MRThermostat/TCU/README.md

# TCU
hardware/software for thermostat control unit
