MRThermostat/TCU/order_confirmation.PNG

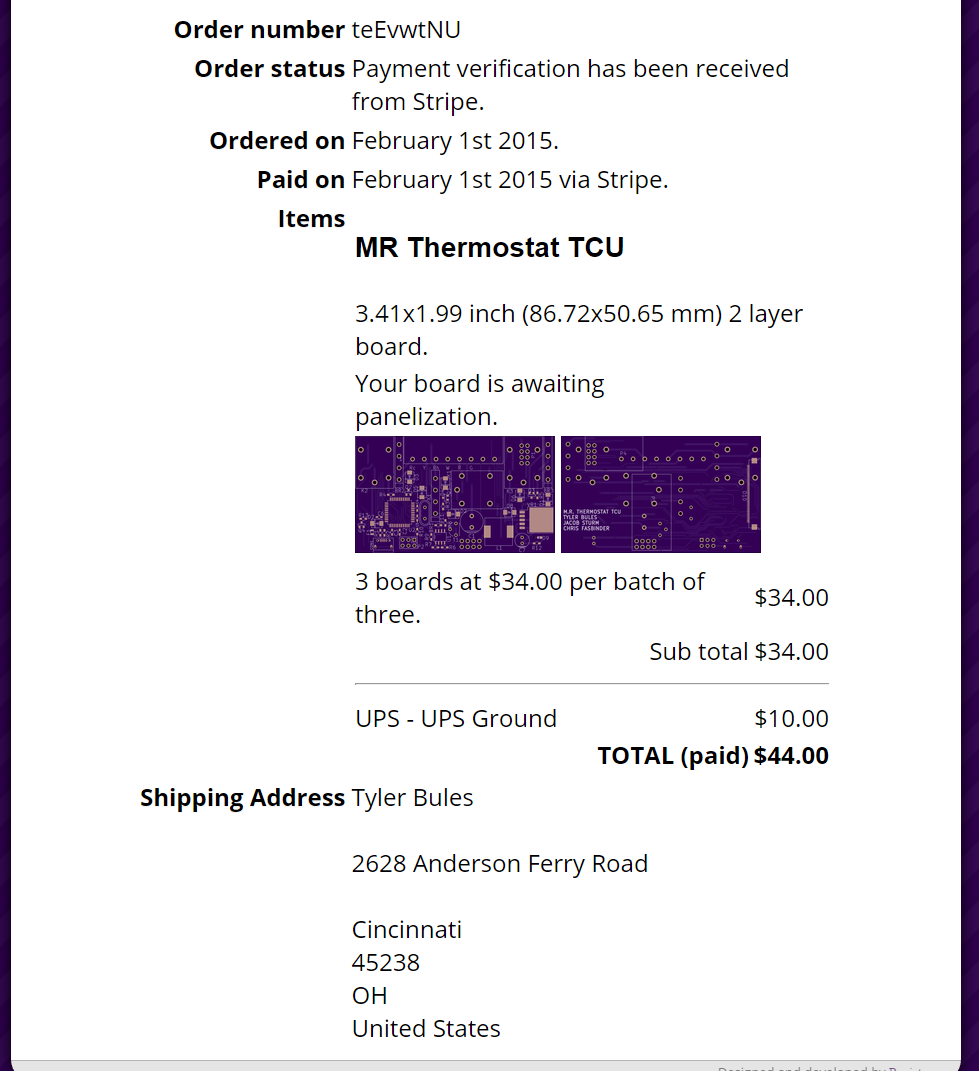
order_confirmation.PNG
