MRThermostat/TCU/TCU_HARDWARE/tcu.pdf

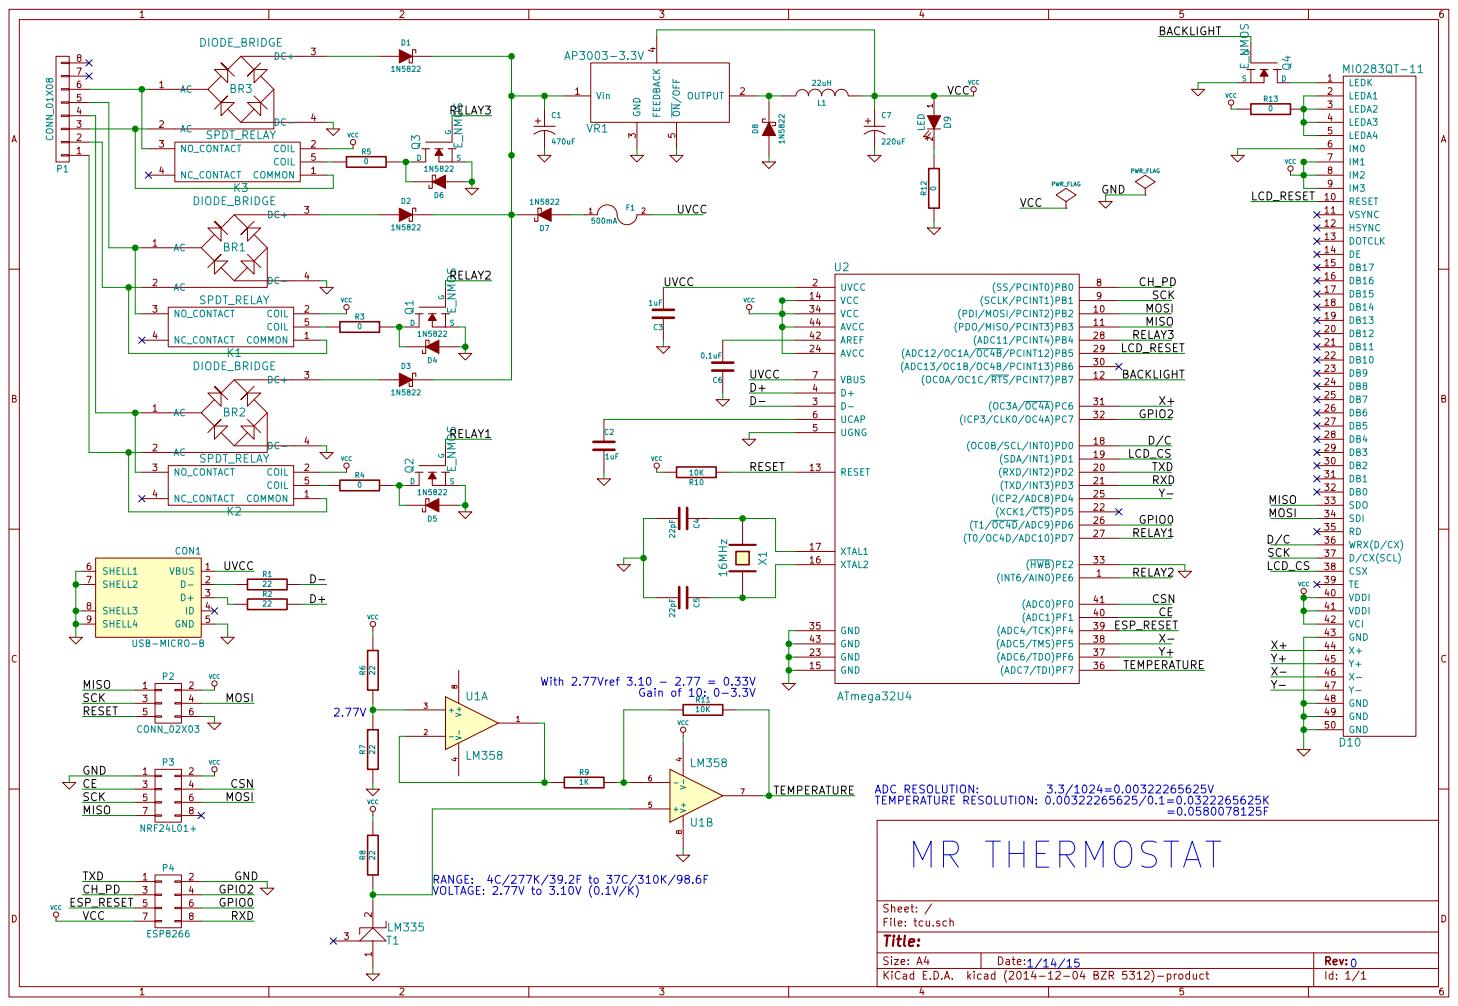
[picture p2: page 1]

MR THERMOSTAT
