MRThermostat/TCU/TCU_HARDWARE/tcu-B_Cu.pdf

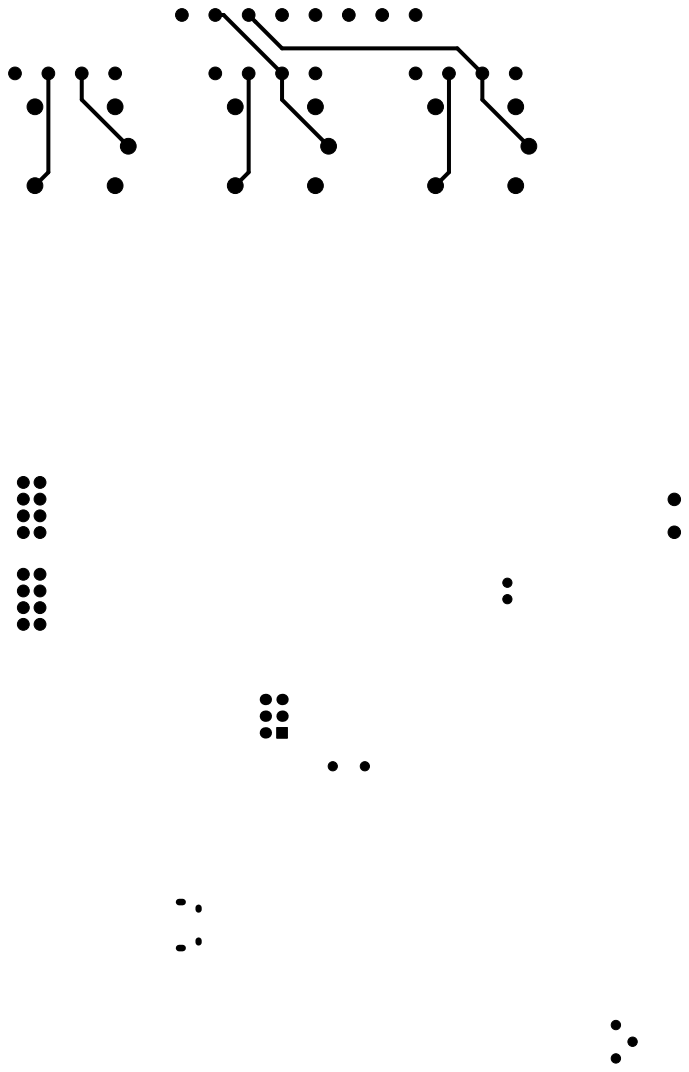
[picture p3: page 1]
