MRThermostat/TCU/TCU_HARDWARE/tcu-B_SilkS.pdf

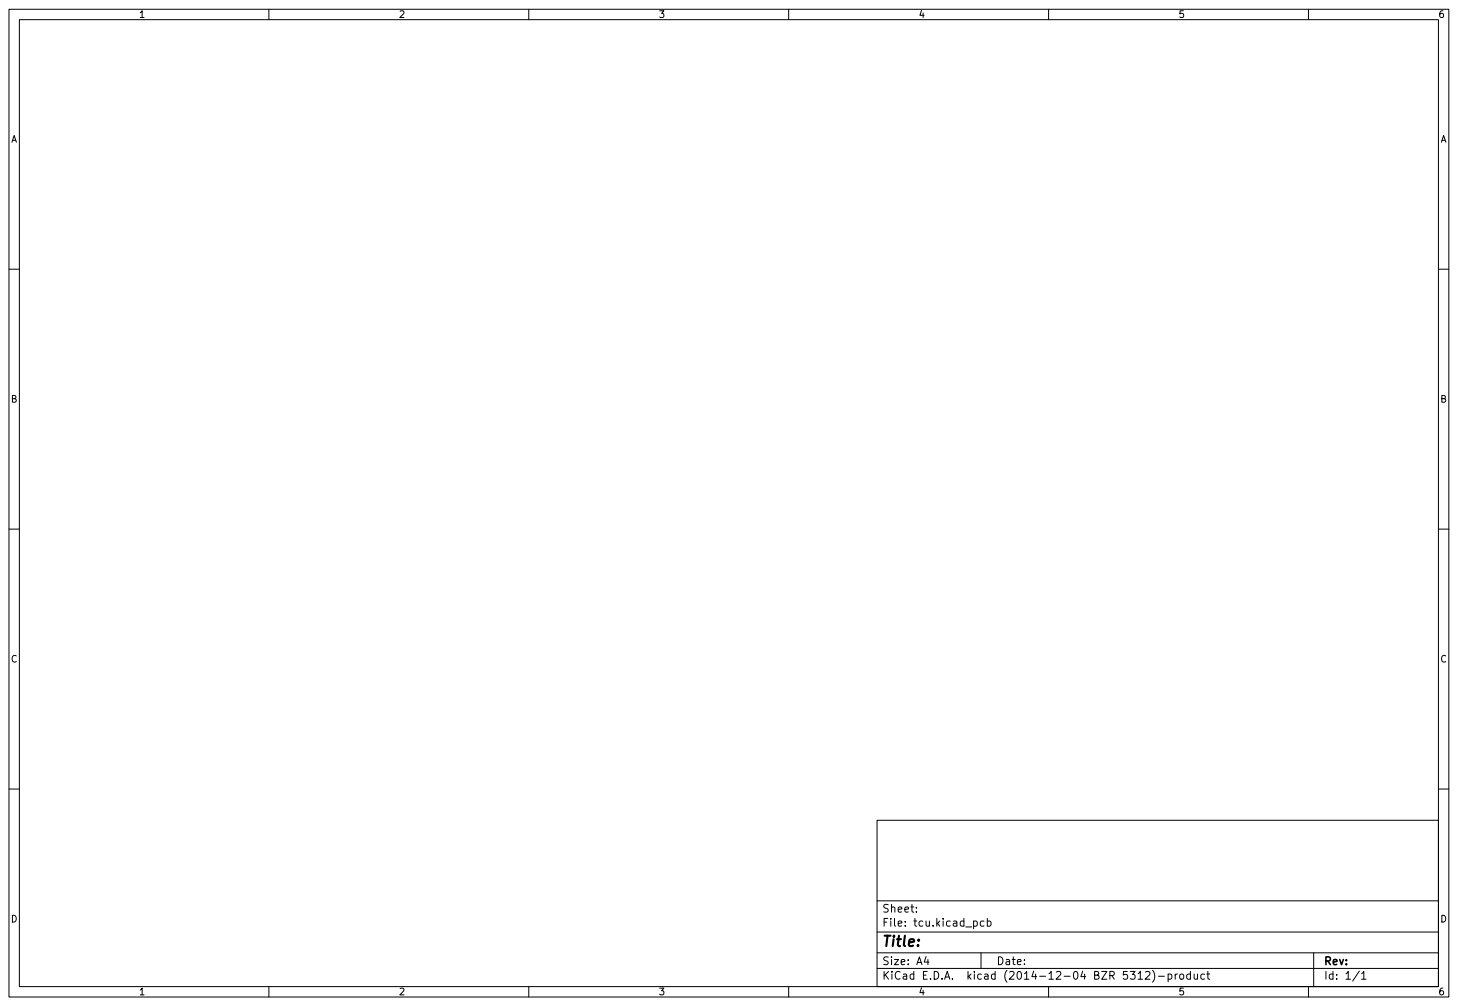
[picture p4: page 1]
