MRThermostat/TCU/TCU_HARDWARE/tcu-F_Cu.pdf

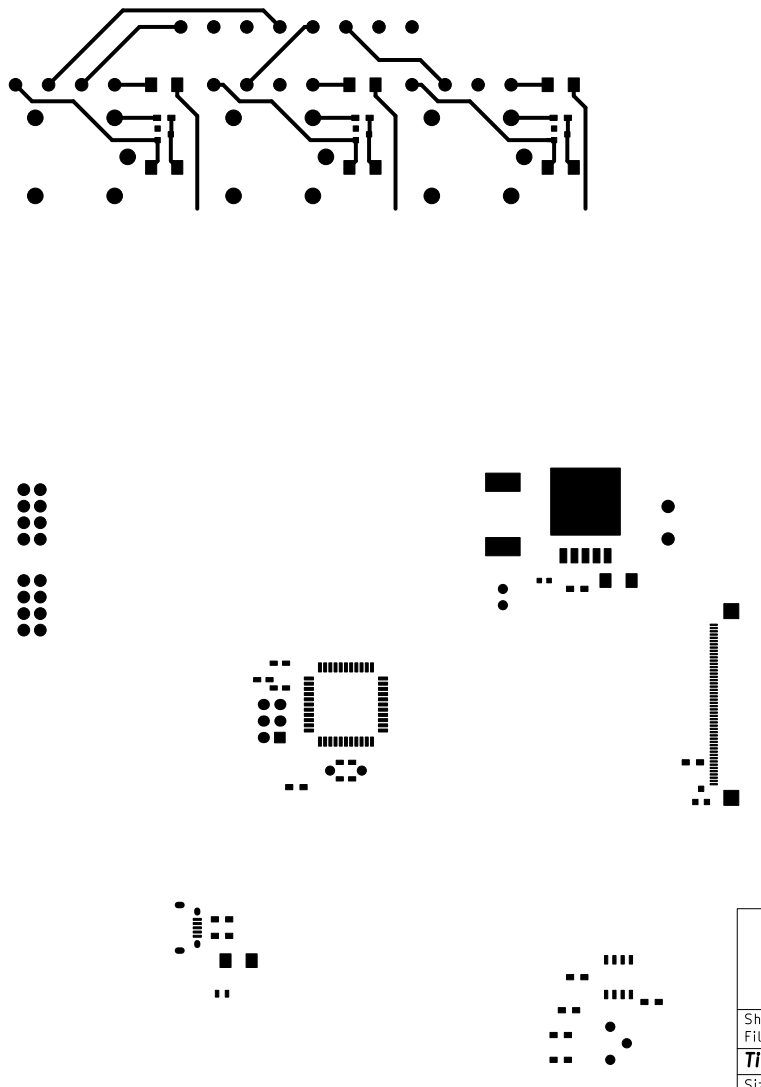
[picture p5: page 1]
