MRThermostat/TCU/TCU_HARDWARE/tcu-F_SilkS.pdf

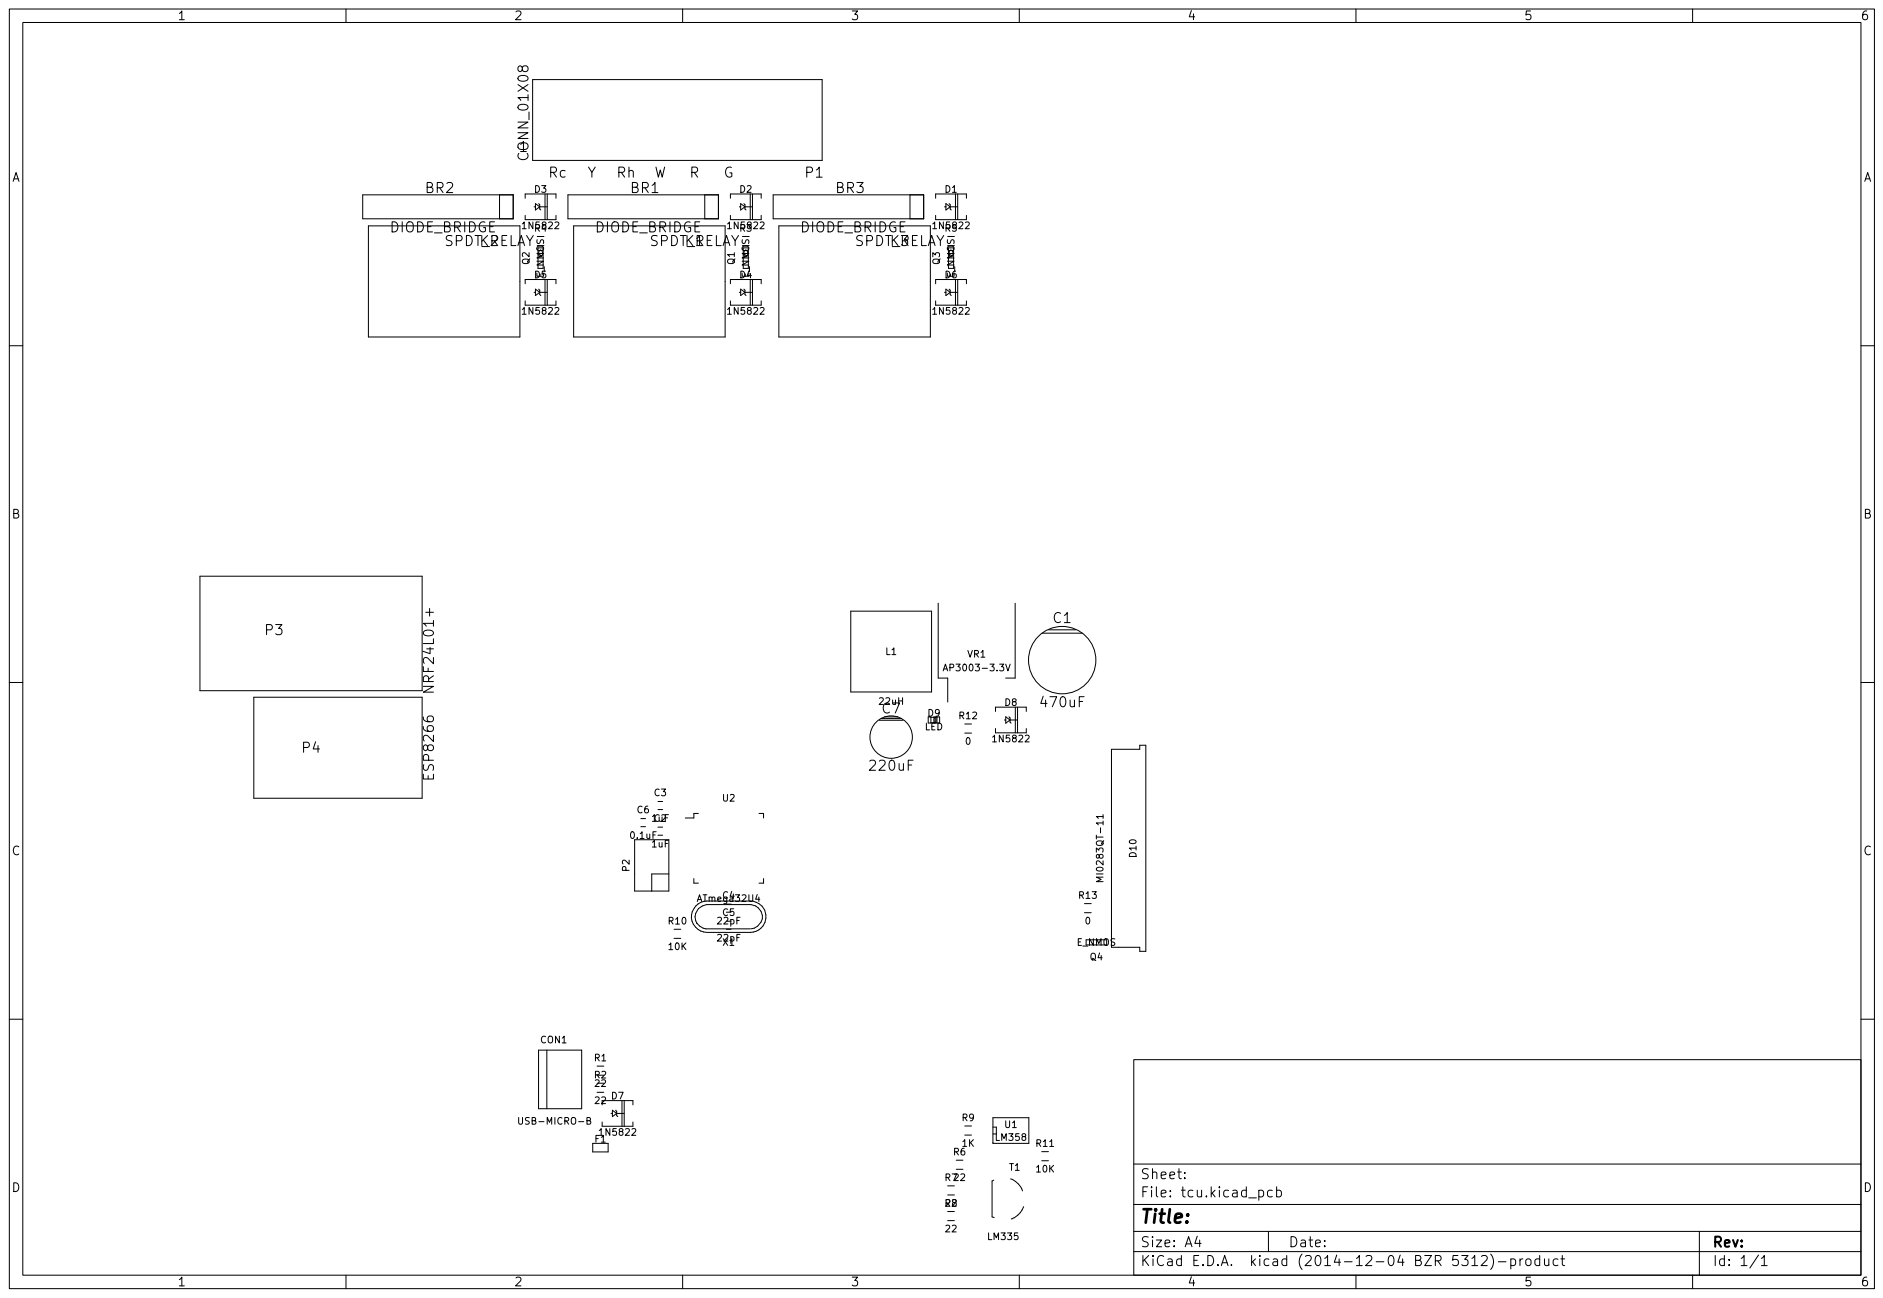
[picture p6: page 1]
