MRThermostat/TCU/TCU_HARDWARE/gerbers/tcu-B_Cu.pdf

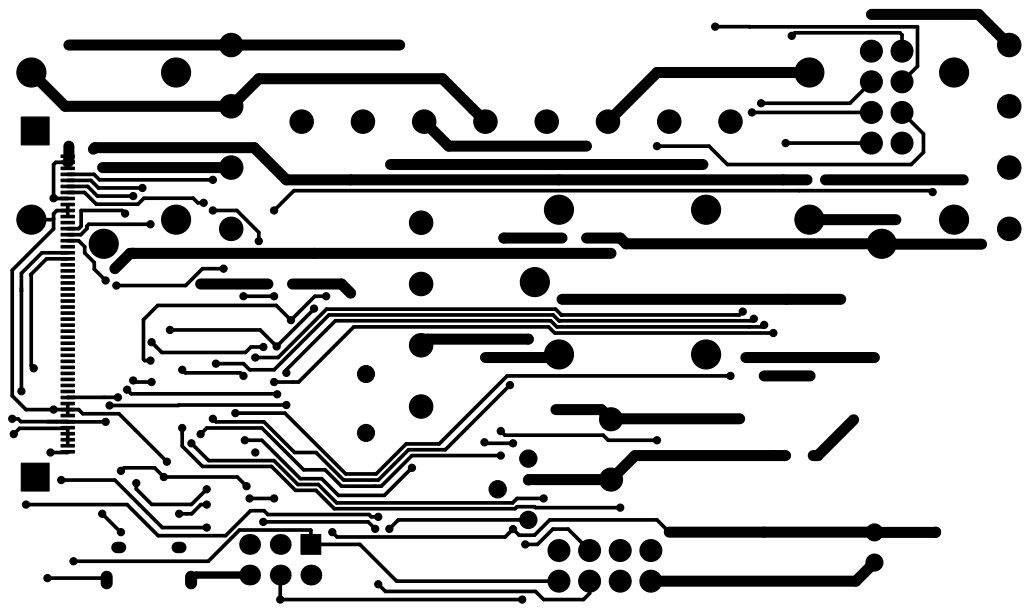
[picture p7: page 1]
