MRThermostat/TCU/TCU_HARDWARE/gerbers/tcu-B_Mask.pdf

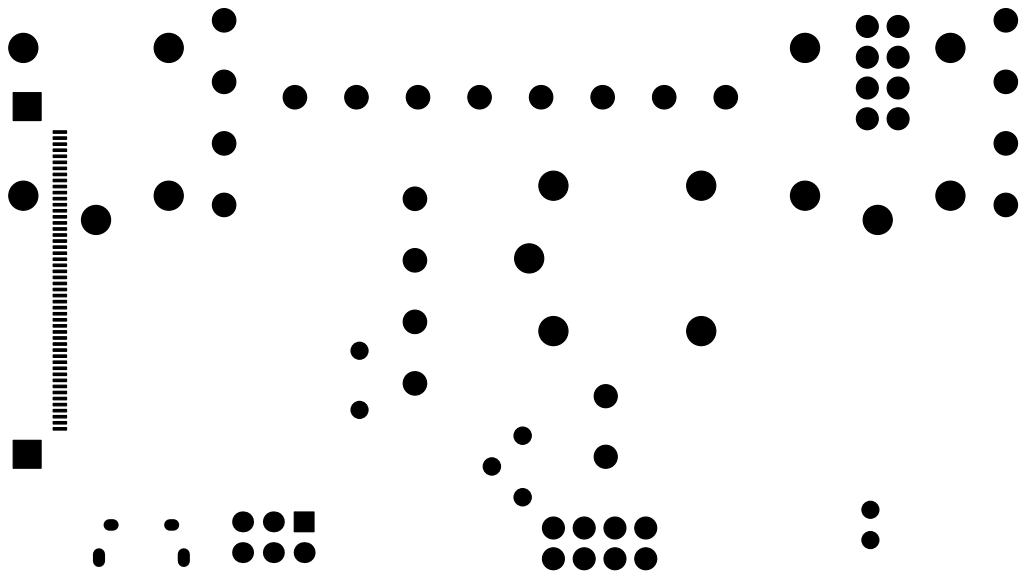
[picture p8: page 1]
