MRThermostat/TCU/TCU_HARDWARE/gerbers/tcu-B_SilkS.pdf

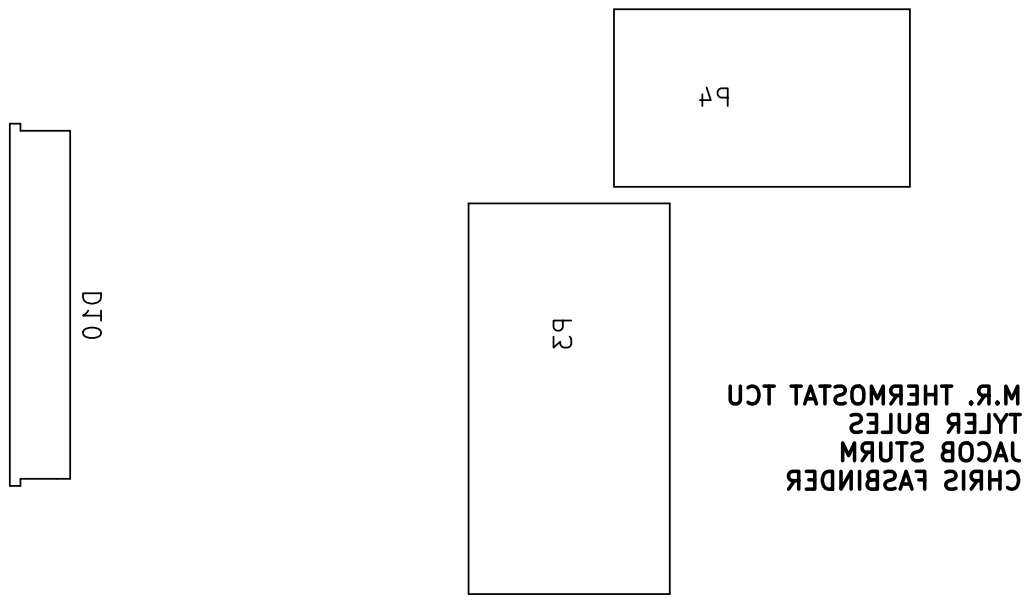
[picture p9: page 1]
