MRThermostat/TCU/TCU_HARDWARE/gerbers/tcu-F_Cu.pdf

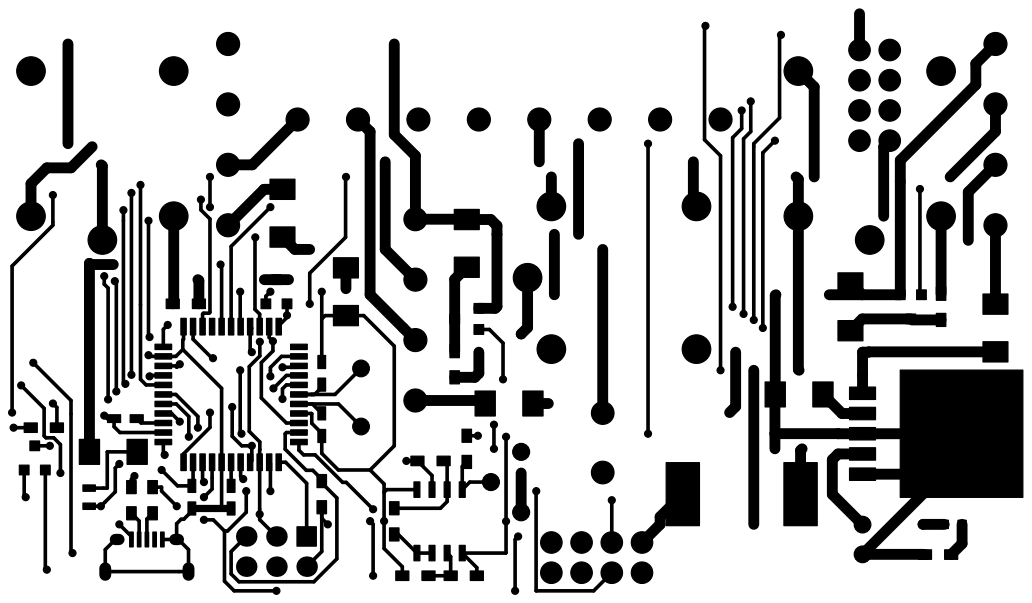
[picture p10: page 1]
