MRThermostat/TCU/TCU_HARDWARE/gerbers/tcu-F_Mask.pdf

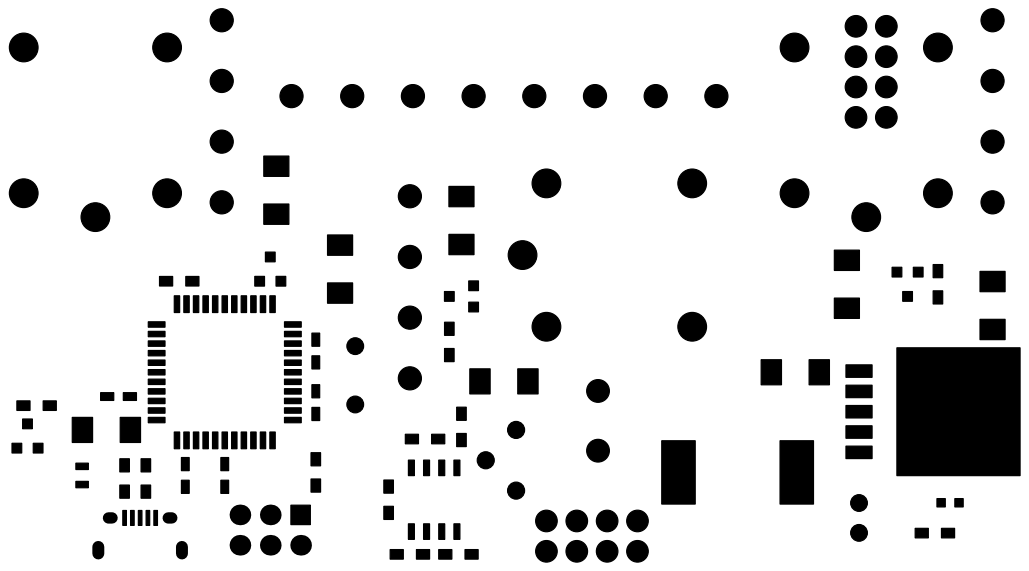
[picture p11: page 1]
