MRThermostat/TCU/TCU_HARDWARE/gerbers/tcu-F_SilkS.pdf

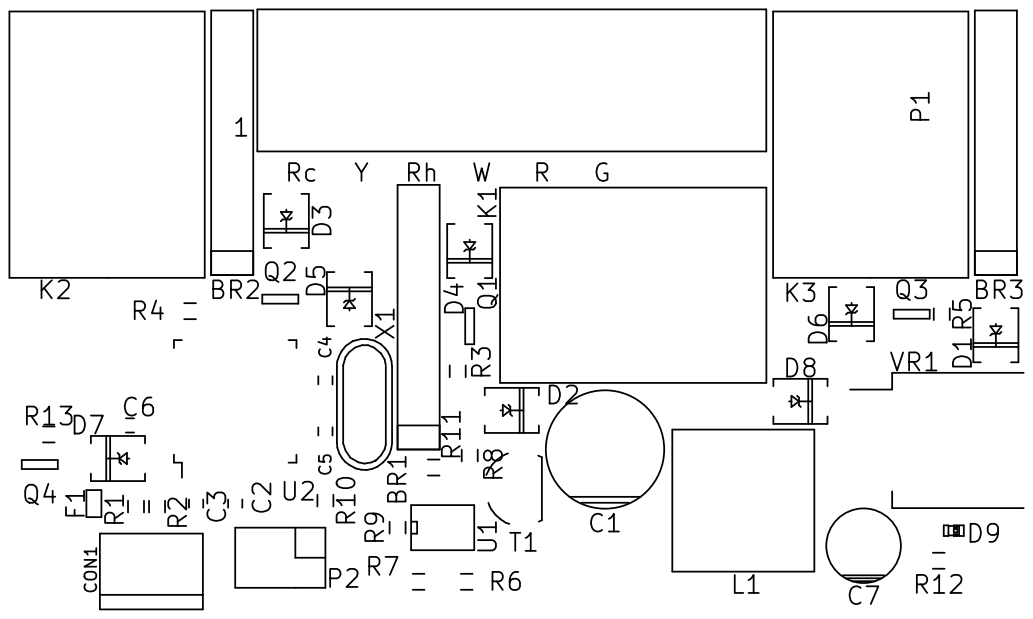
[picture p12: page 1]
