MRThermostat/TCU/ENG_CD_796638_C6.pdf

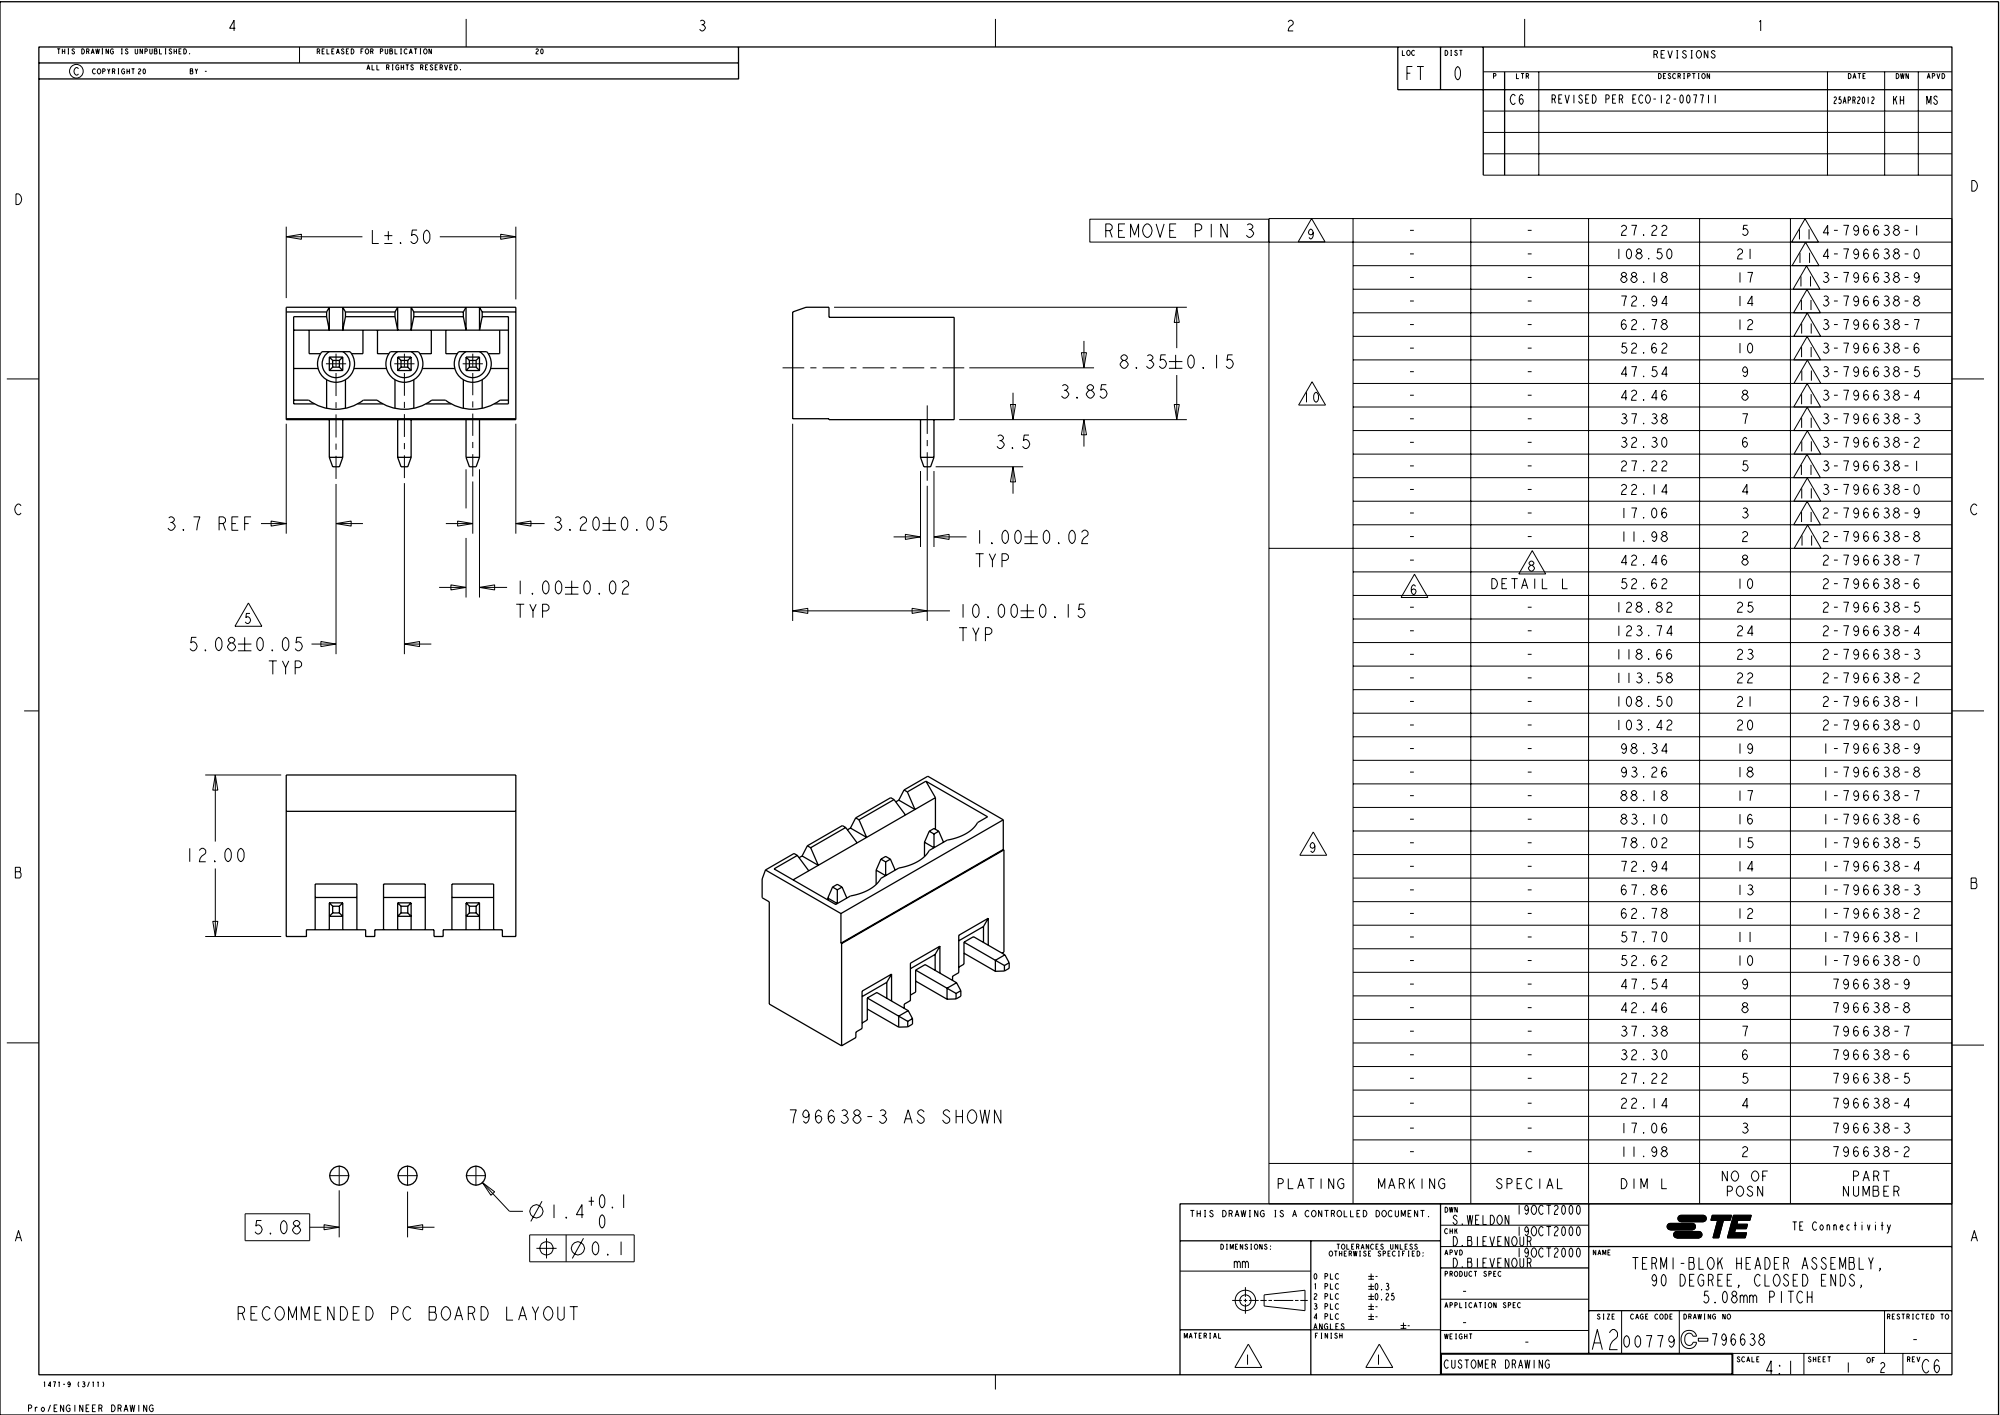
[picture p13: page 1]

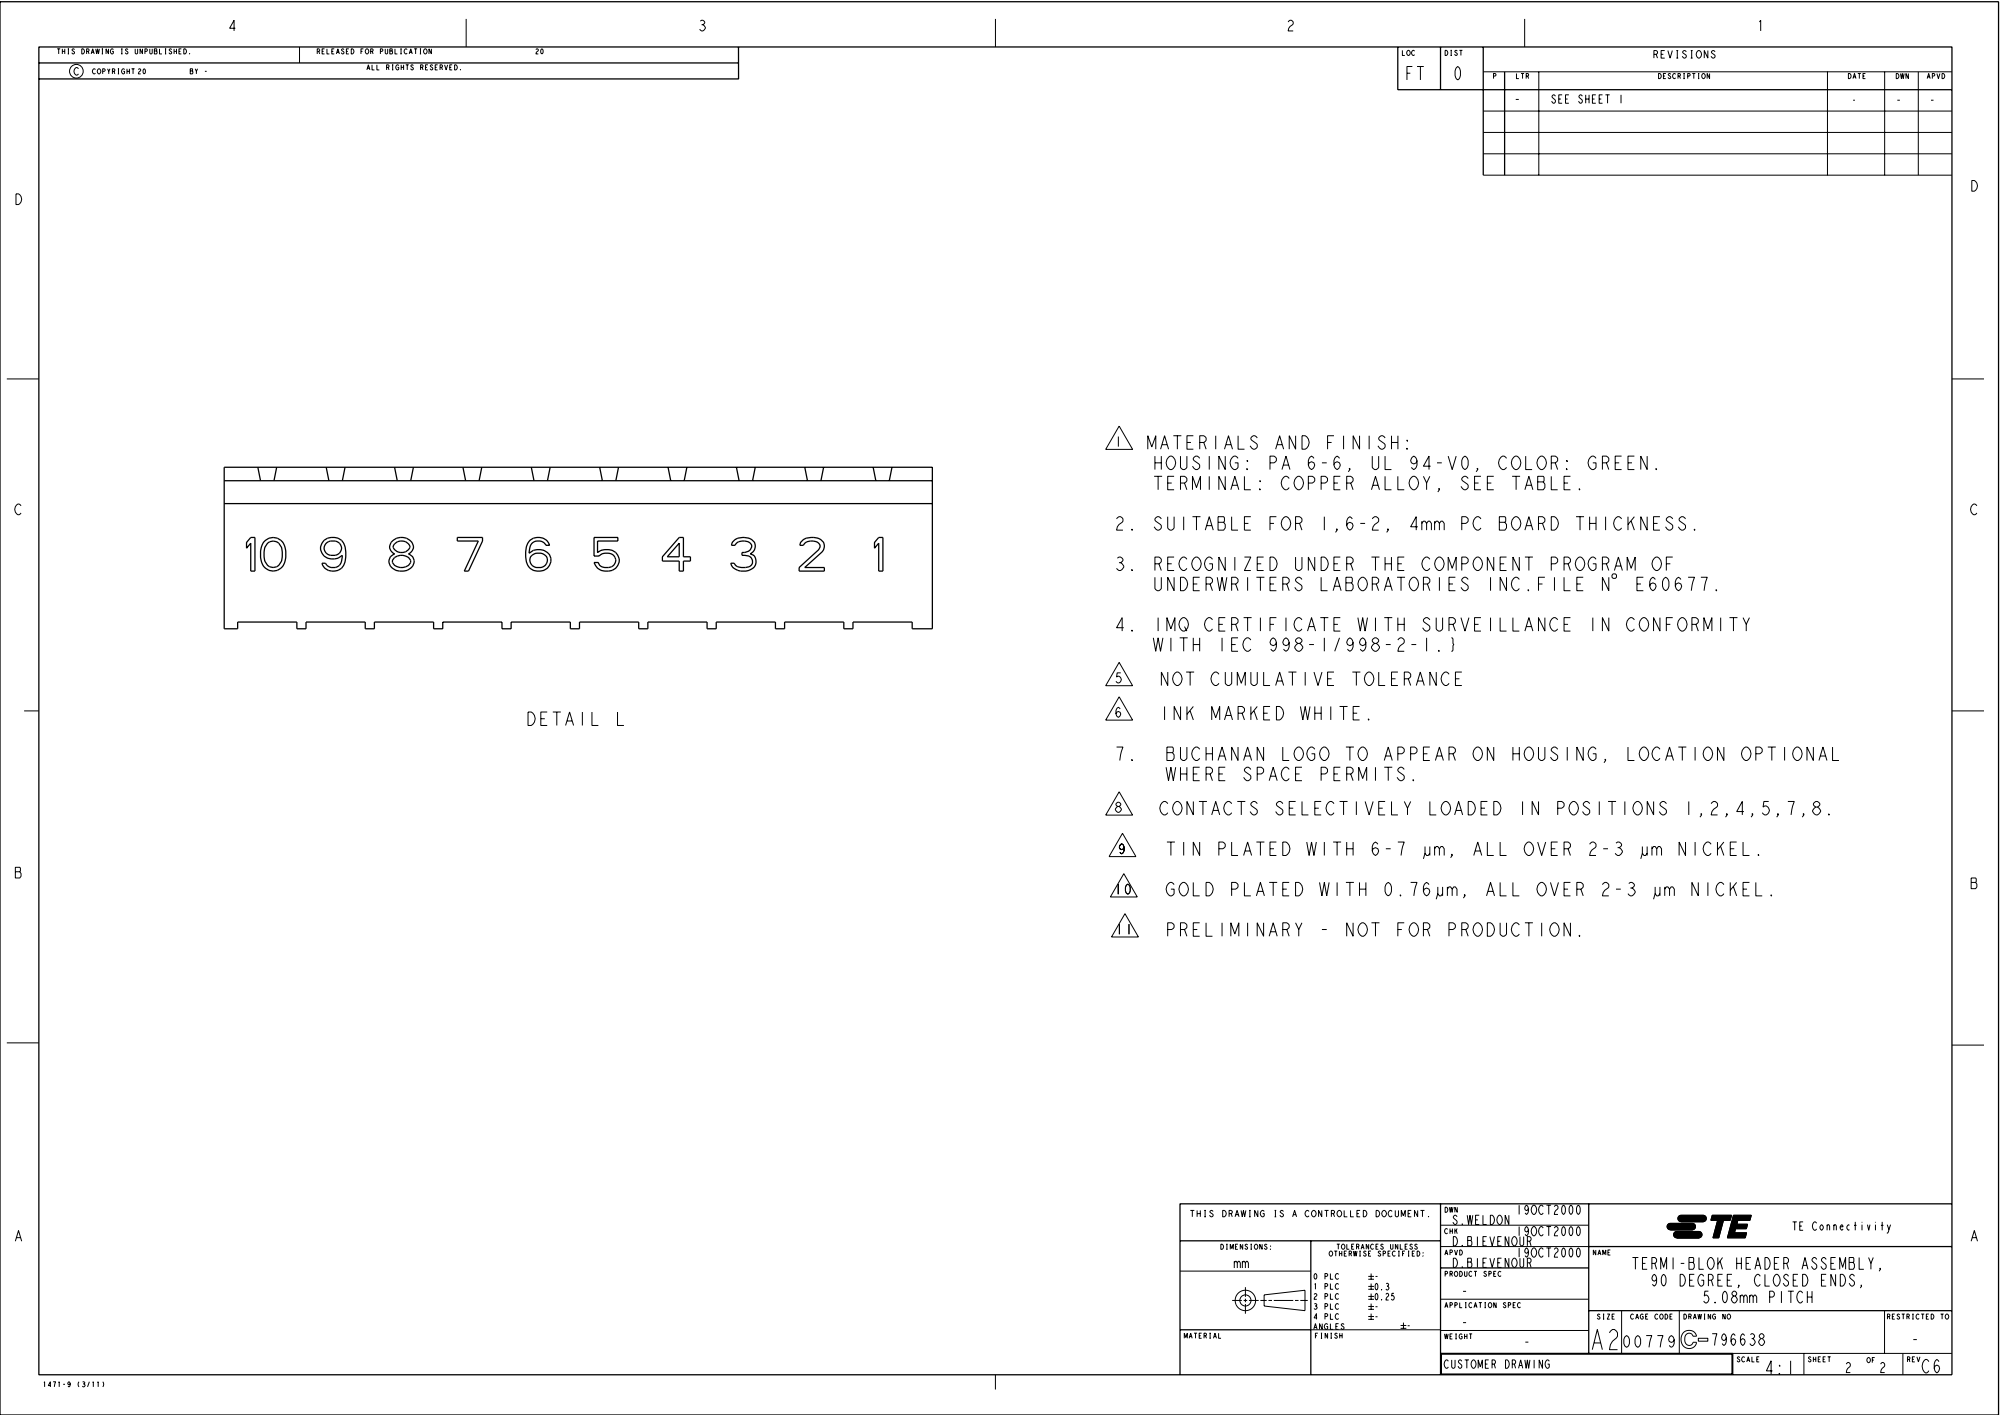
[picture p14: page 2]
