MRThermostat/TCU/TCU_HARDWARE/tcu.kicad_pcb

## KiCad design TCU_HARDWARE/tcu.kicad_pcb (2015-02-01)

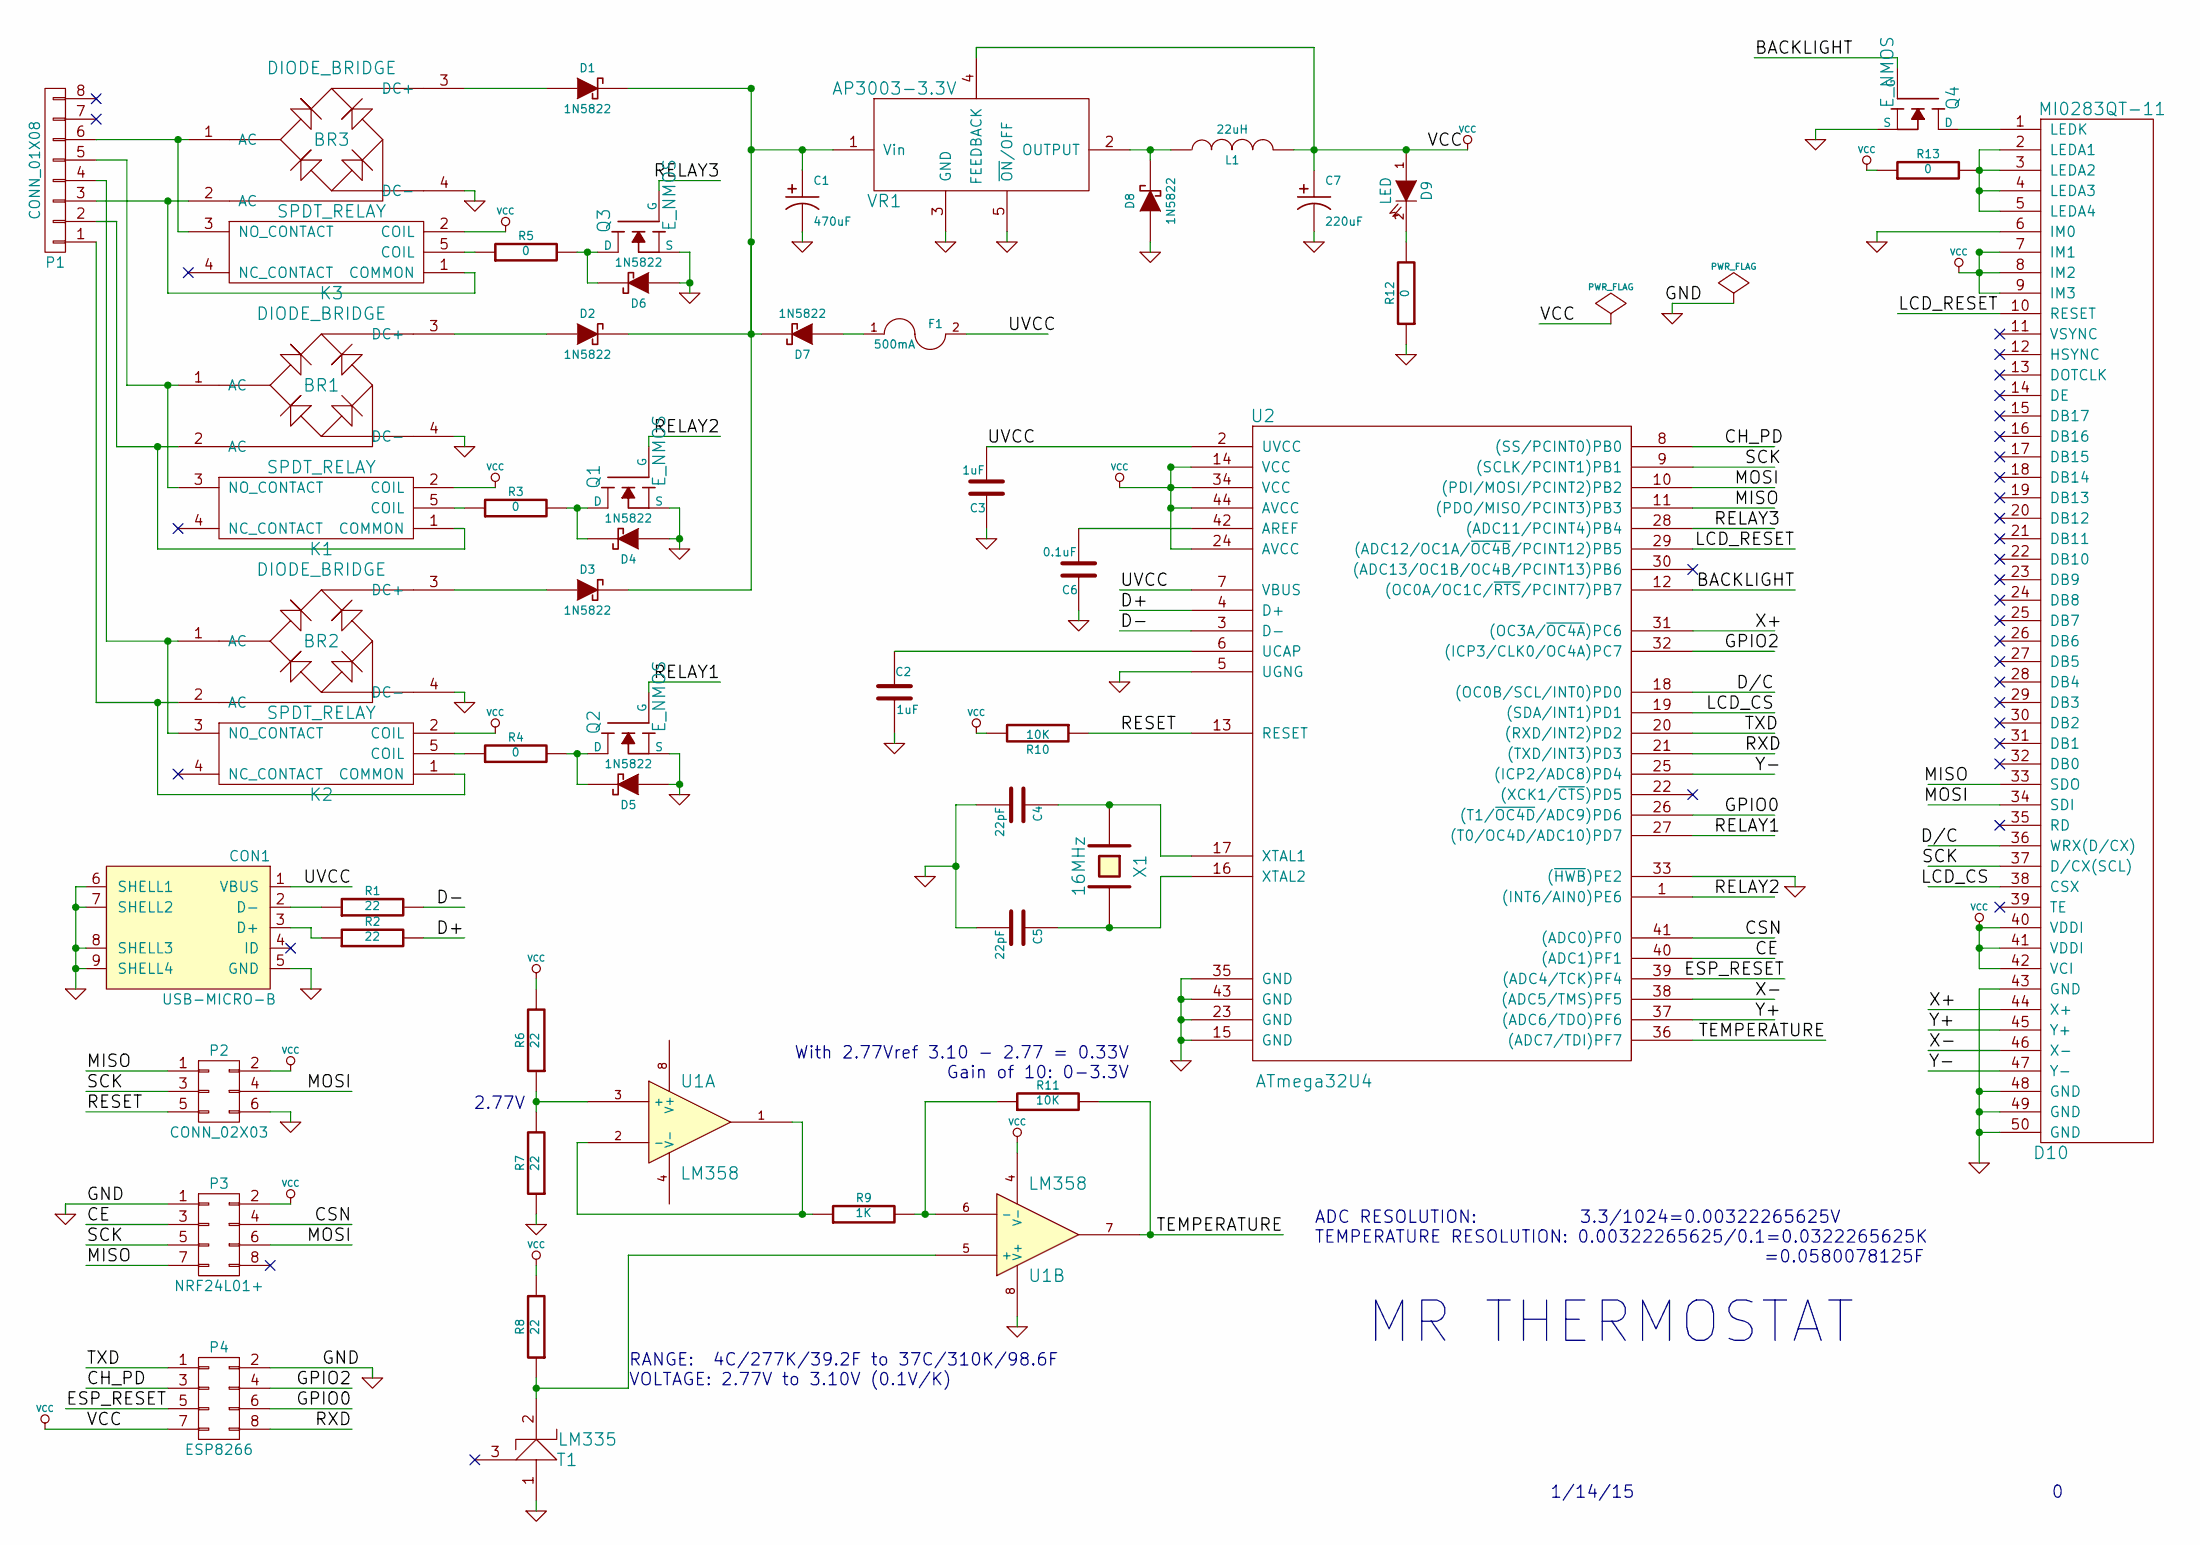
[picture p15: schematic tcu.sch]

Parts:
BR1, BR2, BR3: DIODE_BRIDGE; GBU4
C1: 470uF; CAP_POL_10
C2, C3: 1uF; C_0603_HandSoldering
C4, C5: 22pF; C_0603_HandSoldering
C6: 0.1uF; C_0603_HandSoldering
C7: 220uF; CAP_POL_6.3
CON1: USB-MICRO-B; USB_Micro-B
D1, D2, D3, D4, D5, D6, D7, D8: 1N5822; DO-214-AA_SMB
D9: LED; LED-0603
D10: MI0283QT-11; FPC CONNECTOR
F1: 500mA; SMD-0603
K1, K2, K3: SPDT_RELAY; G5LE
L1: 22uH; SMD_Inductor
P1: CONN_01X08; 796638-8
P2: CONN_02X03; Pin_Header_Straight_2x03
P3: NRF24L01+
P4: ESP8266
Q1, Q2, Q3, Q4: E_NMOS; SOT-23-GDS
R1, R2, R6, R7, R8: 22; R_0603_HandSoldering
R3, R4, R5, R12, R13: 0; R_0603_HandSoldering
R9: 1K; R_0603_HandSoldering
R10, R11: 10K; R_0603_HandSoldering
T1: LM335; TO-92-Free-molded-wide
U1: LM358; SOIC-8-W
U2: ATmega32U4; TQFP-44_10x10mm_Pitch0.8mm
VR1: AP3003-3.3V; TO-263-5_HandSoldering
X1: 16MHz; Crystal_HC49-U_Vertical

Connections:
/BACKLIGHT: Q4.G, U2.12 ((OC0A/OC1C/~RTS~/PCINT7)PB7)
/CE: P3.3, U2.40 ((ADC1)PF1)
/CH_PD: P4.3, U2.8 ((SS/PCINT0)PB0)
/CSN: P3.4, U2.41 ((ADC0)PF0)
/D+: R2.2, U2.4 (D+)
/D-: R1.2, U2.3 (D-)
/D/C: D10.36 (WRX(D/CX)), U2.18 ((OC0B/SCL/INT0)PD0)
/ESP_RESET: P4.5, U2.39 ((ADC4/TCK)PF4)
/GPIO0: P4.6, U2.26 ((T1/~OC4D~/ADC9)PD6)
/GPIO2: P4.4, U2.32 ((ICP3/CLK0/OC4A)PC7)
/LCD_CS: D10.38 (CSX), U2.19 ((SDA/INT1)PD1)
/LCD_RESET: D10.10 (RESET), U2.29 ((ADC12/OC1A/~OC4B~/PCINT12)PB5)
/MISO: D10.33 (SDO), P2.1, P3.7, U2.11 ((PDO/MISO/PCINT3)PB3)
/MOSI: D10.34 (SDI), P2.4, P3.6, U2.10 ((PDI/MOSI/PCINT2)PB2)
/RELAY1: Q2.G, U2.27 ((T0/OC4D/ADC10)PD7)
/RELAY2: Q1.G, U2.1 ((INT6/AIN0)PE6)
/RELAY3: Q3.G, U2.28 ((ADC11/PCINT4)PB4)
/RESET: P2.5, R10.1, U2.13 (RESET)
/RXD: P4.8, U2.21 ((TXD/INT3)PD3)
/SCK: D10.37 (D/CX(SCL)), P2.3, P3.5, U2.9 ((SCLK/PCINT1)PB1)
/TEMPERATURE: R11.2, U1.7, U2.36 ((ADC7/TDI)PF7)
/TXD: P4.1, U2.20 ((RXD/INT2)PD2)
/UVCC: C3.2, CON1.1 (VBUS), F1.2, U2.2 (UVCC), U2.7 (VBUS)
/X+: D10.44 (X+), U2.31 ((OC3A/~OC4A~)PC6)
/X-: D10.46 (X-), U2.38 ((ADC5/TMS)PF5)
/Y+: D10.45 (Y+), U2.37 ((ADC6/TDO)PF6)
/Y-: D10.47 (Y-), U2.25 ((ICP2/ADC8)PD4)
GND: BR1.4 (DC-), BR2.4 (DC-), BR3.4 (DC-), C1.2, C2.2, C3.1, C4.2, C5.2, C6.1, C7.2, CON1.5 (GND), CON1.6 (SHELL1), CON1.7 (SHELL2), CON1.8 (SHELL3), CON1.9 (SHELL4), D4.1 (A), D5.1 (A), D6.1 (A), D8.1 (A), D10.6 (IM0), D10.43 (GND), D10.48 (GND), D10.49 (GND), D10.50 (GND), P2.6, P3.1, P4.2, Q1.S, Q2.S, Q3.S, Q4.S, R7.1, R12.1, T1.1, U1.8 (V+), U2.5 (UGNG), U2.15 (GND), U2.23 (GND), U2.33 ((~HWB~)PE2), U2.35 (GND), U2.43 (GND), VR1.3 (GND), VR1.5 (~ON~/OFF)
unnamed: BR1.1 (AC), K1.3 (NO_CONTACT), P1.5
unnamed: BR1.2 (AC), K1.1 (COMMON), P1.2
unnamed: BR1.3 (DC+), D2.1 (A)
unnamed: BR2.1 (AC), K2.3 (NO_CONTACT), P1.4
unnamed: BR2.2 (AC), K2.1 (COMMON), P1.1
unnamed: BR2.3 (DC+), D3.1 (A)
unnamed: BR3.1 (AC), K3.3 (NO_CONTACT), P1.6
unnamed: BR3.2 (AC), K3.1 (COMMON), P1.3
unnamed: BR3.3 (DC+), D1.1 (A)
unnamed: C1.1, D1.2 (K), D2.2 (K), D3.2 (K), D7.2 (K), VR1.1 (Vin)
unnamed: C2.1, U2.6 (UCAP)
unnamed: C4.1, U2.17 (XTAL1), X1.1
unnamed: C5.1, U2.16 (XTAL2), X1.2
unnamed: C6.2, U2.42 (AREF)
unnamed: CON1.2 (D-), R1.1
unnamed: CON1.3 (D+), R2.1
unnamed: D4.2 (K), Q1.D, R3.2
unnamed: D5.2 (K), Q2.D, R4.2
unnamed: D6.2 (K), Q3.D, R5.2
unnamed: D7.1 (A), F1.1
unnamed: D8.2 (K), L1.1, VR1.2 (OUTPUT)
unnamed: D9.2 (K), R12.2
unnamed: D10.1 (LEDK), Q4.D
unnamed: D10.2 (LEDA1), D10.3 (LEDA2), D10.4 (LEDA3), D10.5 (LEDA4), R13.2
unnamed: K1.5 (COIL), R3.1
unnamed: K2.5 (COIL), R4.1
unnamed: K3.5 (COIL), R5.1
unnamed: R6.1, R7.2, U1.3 (+)
unnamed: R8.1, T1.2, U1.5 (+)
unnamed: R9.1, U1.1, U1.2 (-)
unnamed: R9.2, R11.1, U1.6 (-)
VCC: C7.1, D9.1 (A), D10.7 (IM1), D10.8 (IM2), D10.9 (IM3), D10.40 (VDDI), D10.41 (VDDI), D10.42 (VCI), K1.2 (COIL), K2.2 (COIL), K3.2 (COIL), L1.2, P2.2, P3.2, P4.7, R6.2, R8.2, R10.2, R13.1, U1.4 (V-), U2.14 (VCC), U2.24 (AVCC), U2.34 (VCC), U2.44 (AVCC), VR1.4 (FEEDBACK)

Notes on the sheet:
MR THERMOSTAT
1/14/15
RANGE: 4C/277K/39.2F to 37C/310K/98.6F VOLTAGE: 2.77V to 3.10V (0.1V/K)
ADC RESOLUTION: 3.3/1024=0.00322265625V TEMPERATURE RESOLUTION: 0.00322265625/0.1=0.0322265625K =0.0580078125F
2.77V
With 2.77Vref 3.10 - 2.77 = 0.33V Gain of 10: 0-3.3V

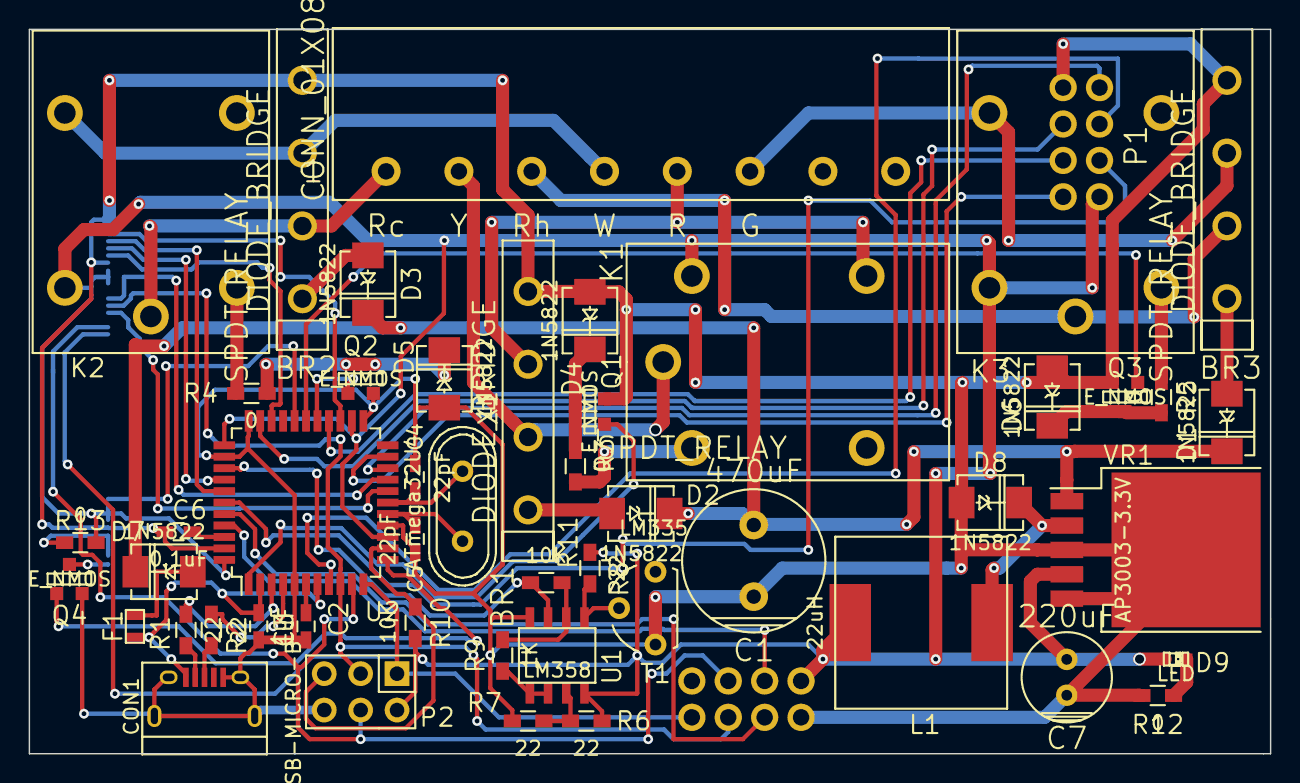
[picture p16: board tcu.kicad_pcb from above]

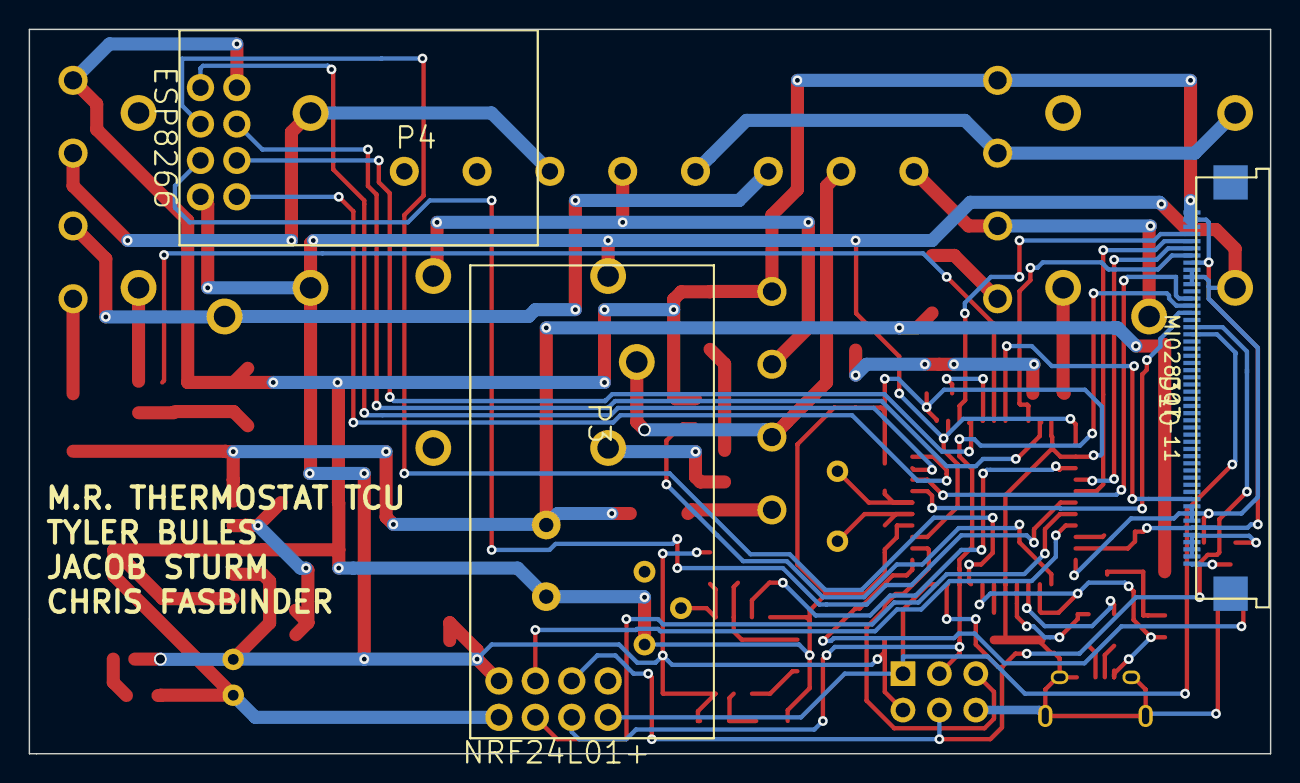
[picture p17: board tcu.kicad_pcb from below]

Board: 2 copper layers, 86.6 x 50.5 mm, 52 parts (3 on the bottom side), 60 nets.
