MRThermostat/TCU/(commit log)

2015-01-27 schematic finished, footprints in progress
    [tcu (1).sch, tcu.sch]
2015-01-27 cleared out the clusterfuck
    [tcu (1).sch, tcu.sch]
2015-01-27 replaced clusterfuck
    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
    [tcu (1).sch, tcu.sch]
2015-01-27 assigned footprint for p2, vr1, p4
2015-01-27 assigned footprints
    d1-d8, U1,t1,
    [tcu.sch]
2015-01-27 cleaned up datasheets, added datasheet for lcd connector clip
2015-01-28 created and assigned display connector footprint
    [tcu.kicad_pcb, tcu.sch]
2015-01-28 fuse footprint selected
    [$tcu.sch]
2015-01-28 created and assigned inductor footprint
2015-01-28 finished footprints... hopefully
2015-01-28 started routing
    external connections mostly done
    [$tcu.sch]
2015-01-29 further work on layout
    [$tcu.sch, tcu.kicad_pcb, tcu.sch]
2015-01-29 squeezing in
    [tcu.kicad_pcb]
2015-01-29 moved left and right relay up
    everything should fit vertically behind screen
    [tcu.kicad_pcb]
2015-01-29 touchscreen routed
    [tcu.kicad_pcb]
2015-01-29 almost done routing lcd
    [tcu.kicad_pcb]
2015-02-01 began routing wifi modules
    [tcu.kicad_pcb]
2015-02-01 esp8266 at bottom
    [tcu.kicad_pcb]
2015-02-01 ALL ROUTING COMPLETE
    [tcu.kicad_pcb]
2015-02-01 normalized fonts and aligned references
    also rerouted backlight trace
    [tcu.kicad_pcb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]
2015-02-01 generated, renamed, and packaged gerbers
    [tcu.drl, tcu.gbl, tcu.gbo, tcu.gbs, tcu.gko, tcu.gtl, tcu.gto, tcu.gts]
2015-02-01 fixed fastbinder to fasbinder
    new gerbers generated and packaged. sending for quote.
    [tcu.drl, tcu.gbl, tcu.gbo, tcu.gbs, tcu.gko, tcu.gtl, tcu.gto, tcu.gts]
2015-02-03 modified folder structure. preparing for software
    [tcu (1).sch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]
2015-02-04 added pin definitions
    [tcu.sch]
2015-02-10 Testing
    Backing up to protect from crashing
    [TCU_FIRMWARE.ino]
2015-02-12 Legit Branch
    Has mainscreen and profile settings GUI with fixed orientation.
    [TCU_FIRMWARE.ino]
2015-02-16 activeList GUI created
    Added some missing ;
    Added GUI for setting a sensor to active/not active
    [TCU_FIRMWARE.ino]
2015-02-17 Sensor Info
    added sensor info gui and edited active sensor list gui
2015-02-17 Sensor Info
    some changes did not go through
2015-02-26 Small Bug fix
    Misplaced do{, caused unnecessary screen reloads
    [TCU_FIRMWARE.ino]
2015-02-26 More Screens
    1. Redone:
    sensorSettings
    sensorEdit
    2. More Touchscreen implementation
    few screens are left
2015-03-04 Optimization
    Created printText, makeTitle, doubleLine functions to reduce memory
    usage. Went from 73% to 68%. Most screens functional
    Sketch uses 19,520 bytes (68%) of program storage space. Maximum is
    28,672 bytes.
    Global variables use 819 bytes (31%) of dynamic memory, leaving 1,741
    bytes for local variables. Maximum is 2,560 bytes.
2015-03-10 still merging....
    working on pin definitions
2015-03-13 Fixed unit conversion
    Corrected K to F conversion
    had -32 needed +32
    [temperature.h]
